OpenAgricultureFoundation/FoamFarmActivity/Pilot Event Photos/Team1.JPG

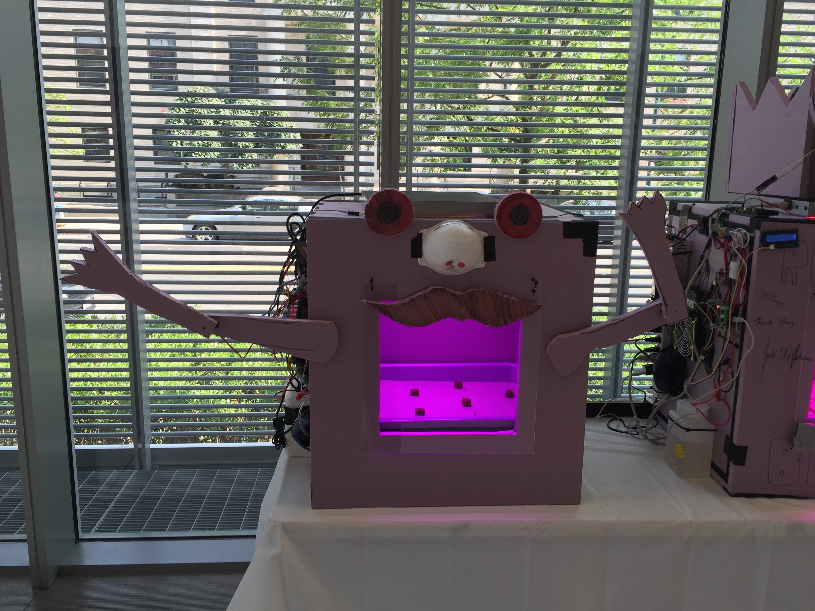
Pilot Event Photos/Team1.JPG
