OpenAgricultureFoundation/FoamFarmActivity/Pilot Event Photos/Team6.JPG

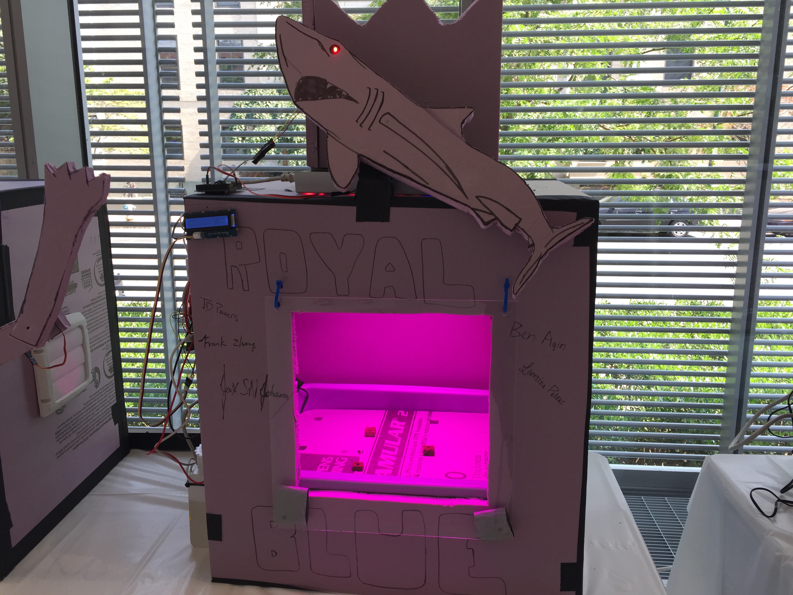
Pilot Event Photos/Team6.JPG
