OpenAgricultureFoundation/FoamFarmActivity/Foam Farm Chassis/window_dimensions.pdf

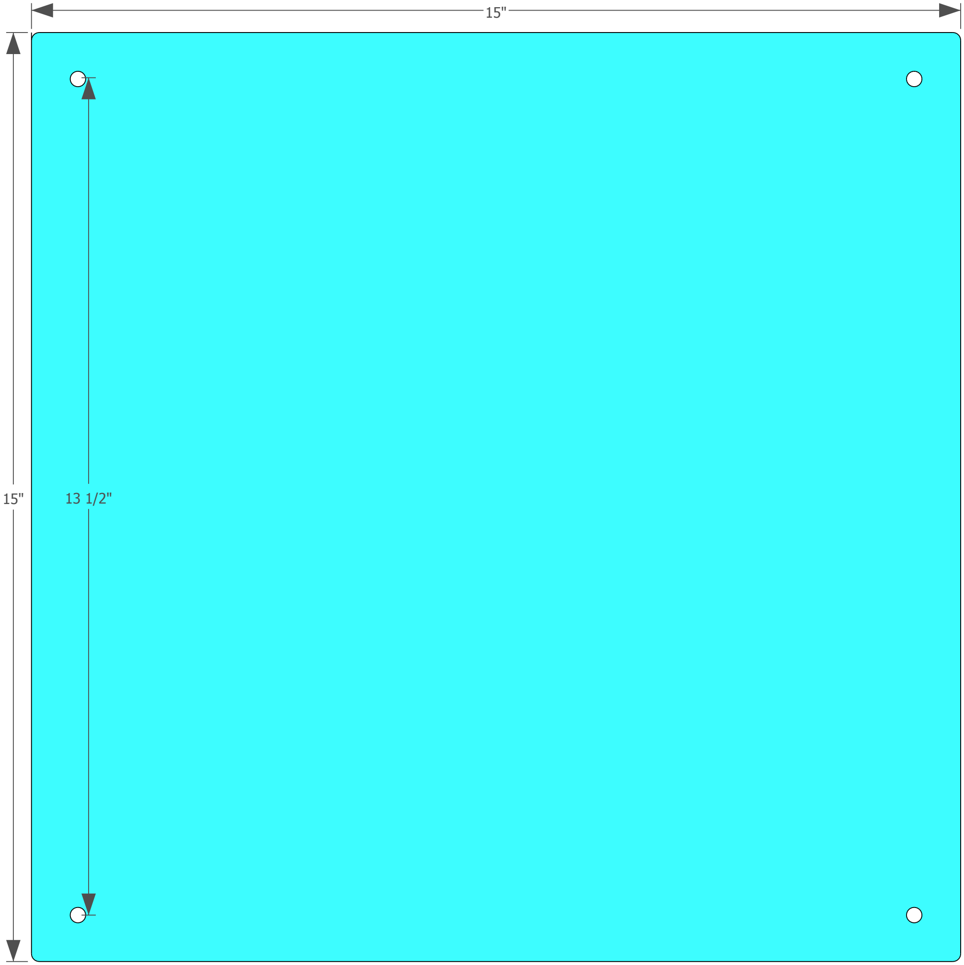
[picture p3: figure]
