OpenAgricultureFoundation/FoamFarmActivity/Foam Farm Chassis/panel_cut_templates/printable_cut_templates/chassis_cut_template01.jpg

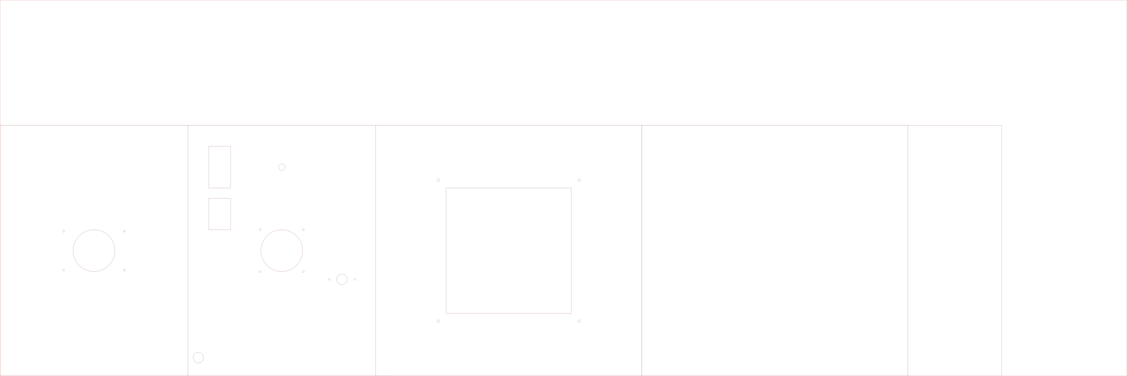
Foam Farm Chassis/panel_cut_templates/printable_cut_templates/chassis_cut_template01.jpg
