OpenAgricultureFoundation/FoamFarmActivity/Pilot Event Photos/Student Bots on Display in Media Lab Lobby.JPG

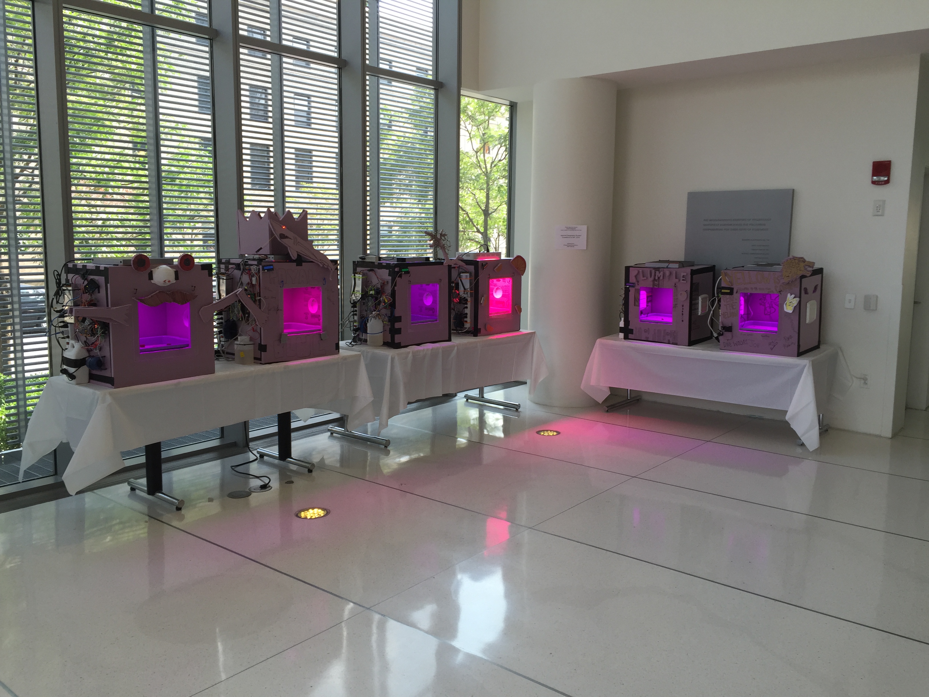
Pilot Event Photos/Student Bots on Display in Media Lab Lobby.JPG
