OpenAgricultureFoundation/FoamFarmActivity/Pilot Event Photos/Student Demos.JPG

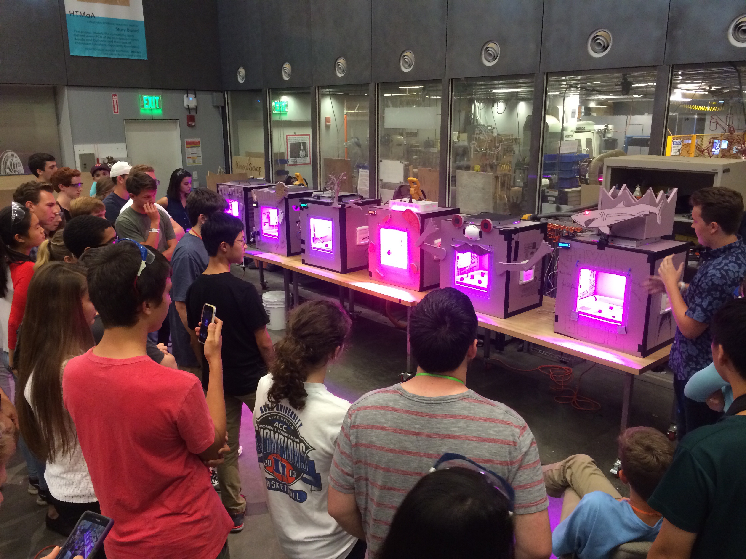
Pilot Event Photos/Student Demos.JPG
