OpenAgricultureFoundation/FoamFarmActivity/Pilot Event Photos/Team2.JPG

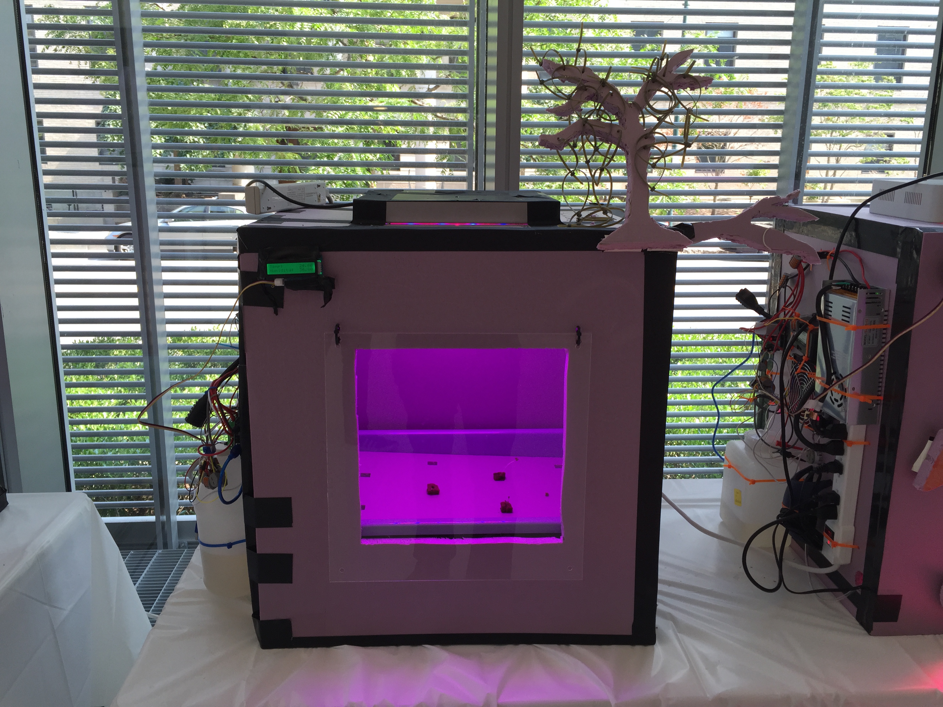
Pilot Event Photos/Team2.JPG
