OpenAgricultureFoundation/FoamFarmActivity/Pilot Event Photos/Team3.JPG

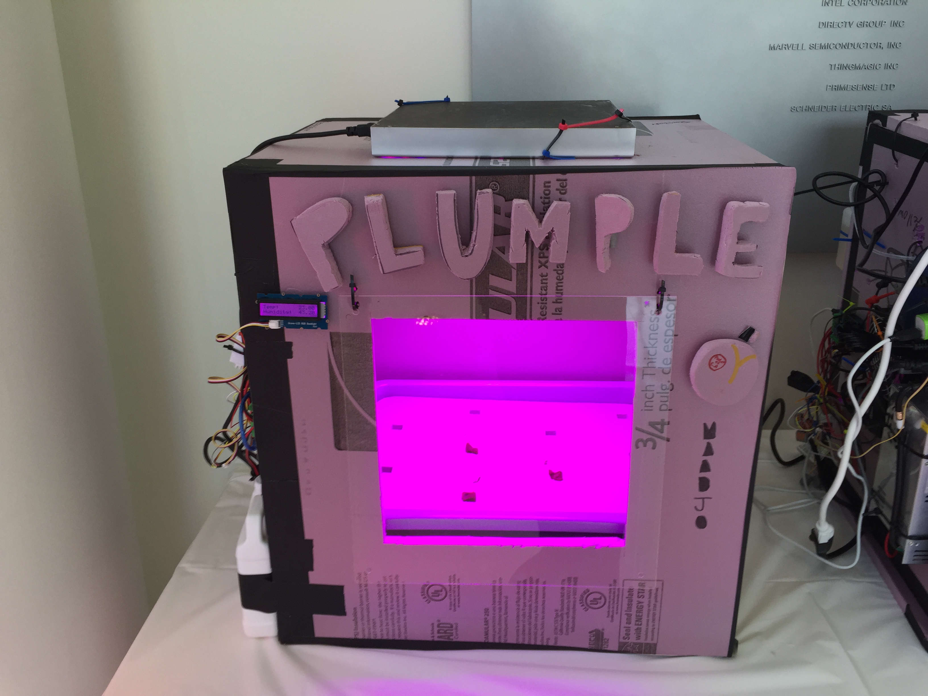
Pilot Event Photos/Team3.JPG
