OpenAgricultureFoundation/FoamFarmActivity/Pilot Event Photos/Team4.JPG

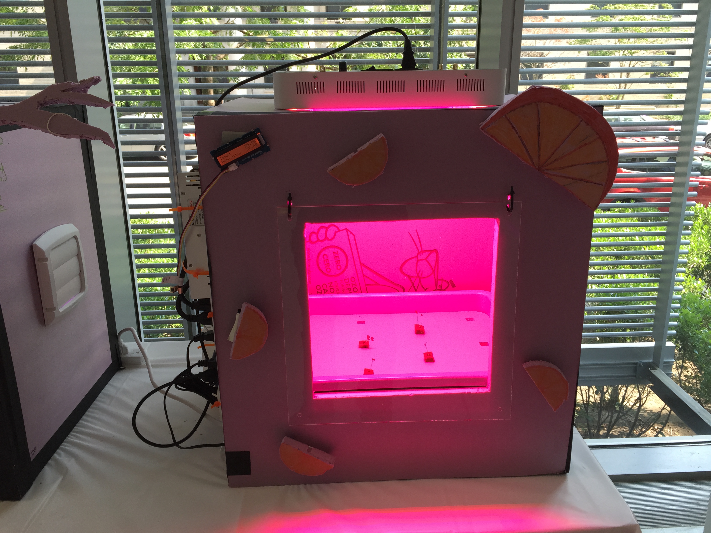
Pilot Event Photos/Team4.JPG
