OpenAgricultureFoundation/FoamFarmActivity/Pilot Event Photos/Team5.JPG

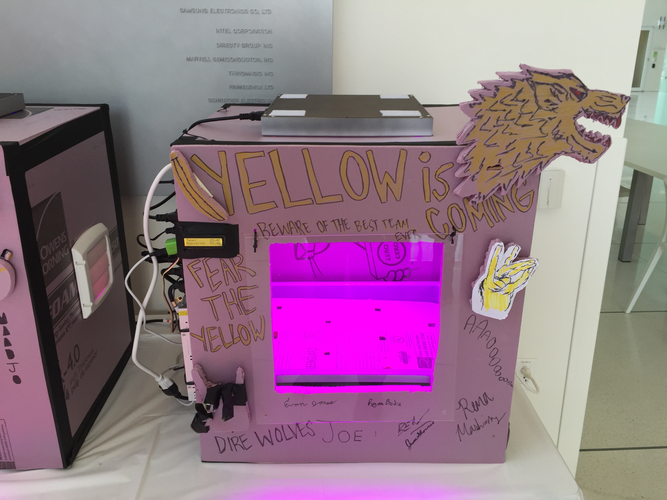
Pilot Event Photos/Team5.JPG
