OpenAgricultureFoundation/FoamFarmActivity/Foam Farm Chassis/3d_files/window_model.stl

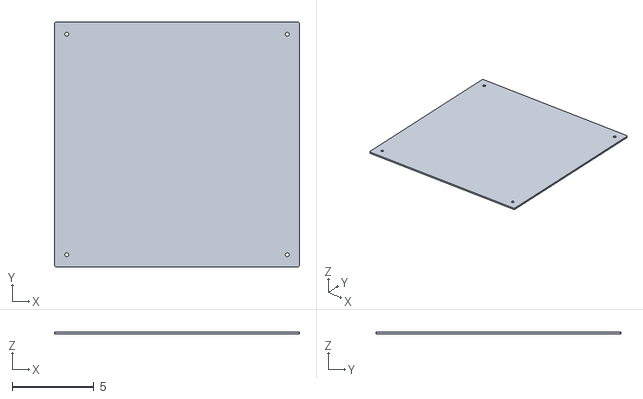
[picture p11: CAD file, 2016-08-10]
Foam Farm Chassis/3d_files/window_model.stl
15.0 x 15.0 x 0.125
