OpenAgricultureFoundation/FoamFarmActivity/Foam Farm Chassis/3d_files/foamfarm_model.stl

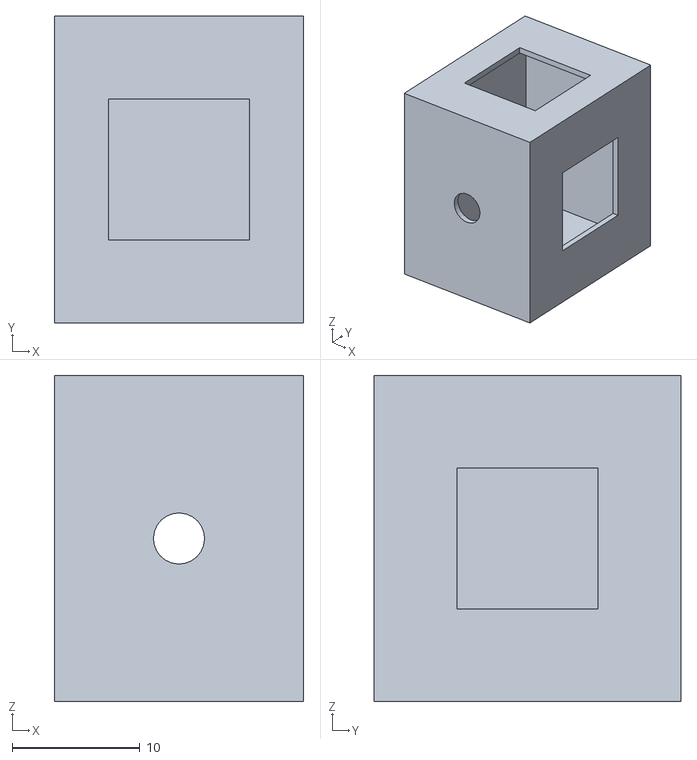
[picture p12: CAD file, 2016-08-10]
Foam Farm Chassis/3d_files/foamfarm_model.stl
19.5 x 24.0 x 25.5
