OpenAgricultureFoundation/FoamFarmActivity/Foam Farm Chassis/panel_dimensions.pdf

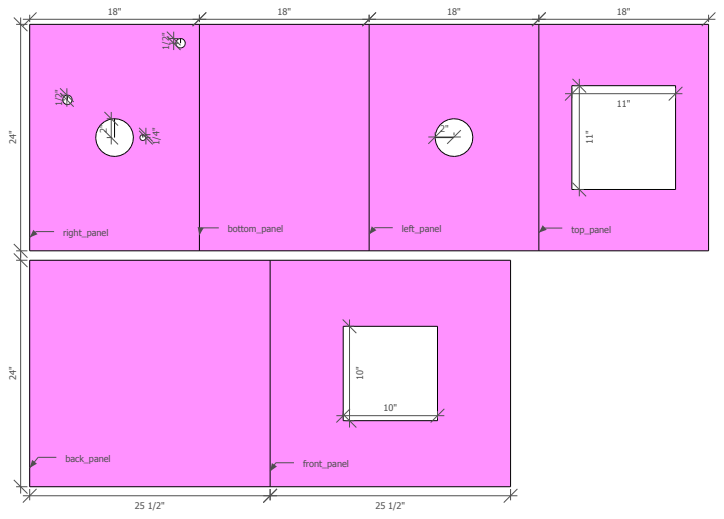
[picture p13: page 1]
right_panel; bottom_panel; left_panel; top_panel; back_panel; front_panel
