OpenAgricultureFoundation/FoamFarmActivity/(commit log)

2017-05-22 upload bom as excel file
    [Bill of Materials.xlsx]
2018-02-23 Fixing Issue #12: adding LCD module to Bill of Materials and regenerating the BoM PDF
    [Bill of Materials.xlsx]
